LogsunSystems/ESP32_DVK/ESP32 DOCUMENTS/ESP32 DVK SCH/ESP_DVK_NEW_2_NOV/ESP_DVK_NEW_1_NOV/ESP_DVK_NEW/Esp_DVK.brd

## EAGLE design ESP32 DOCUMENTS/ESP32 DVK SCH/ESP_DVK_NEW_2_NOV/ESP_DVK_NEW_1_NOV/ESP_DVK_NEW/Esp_DVK.brd (2023-11-11, last stored version)

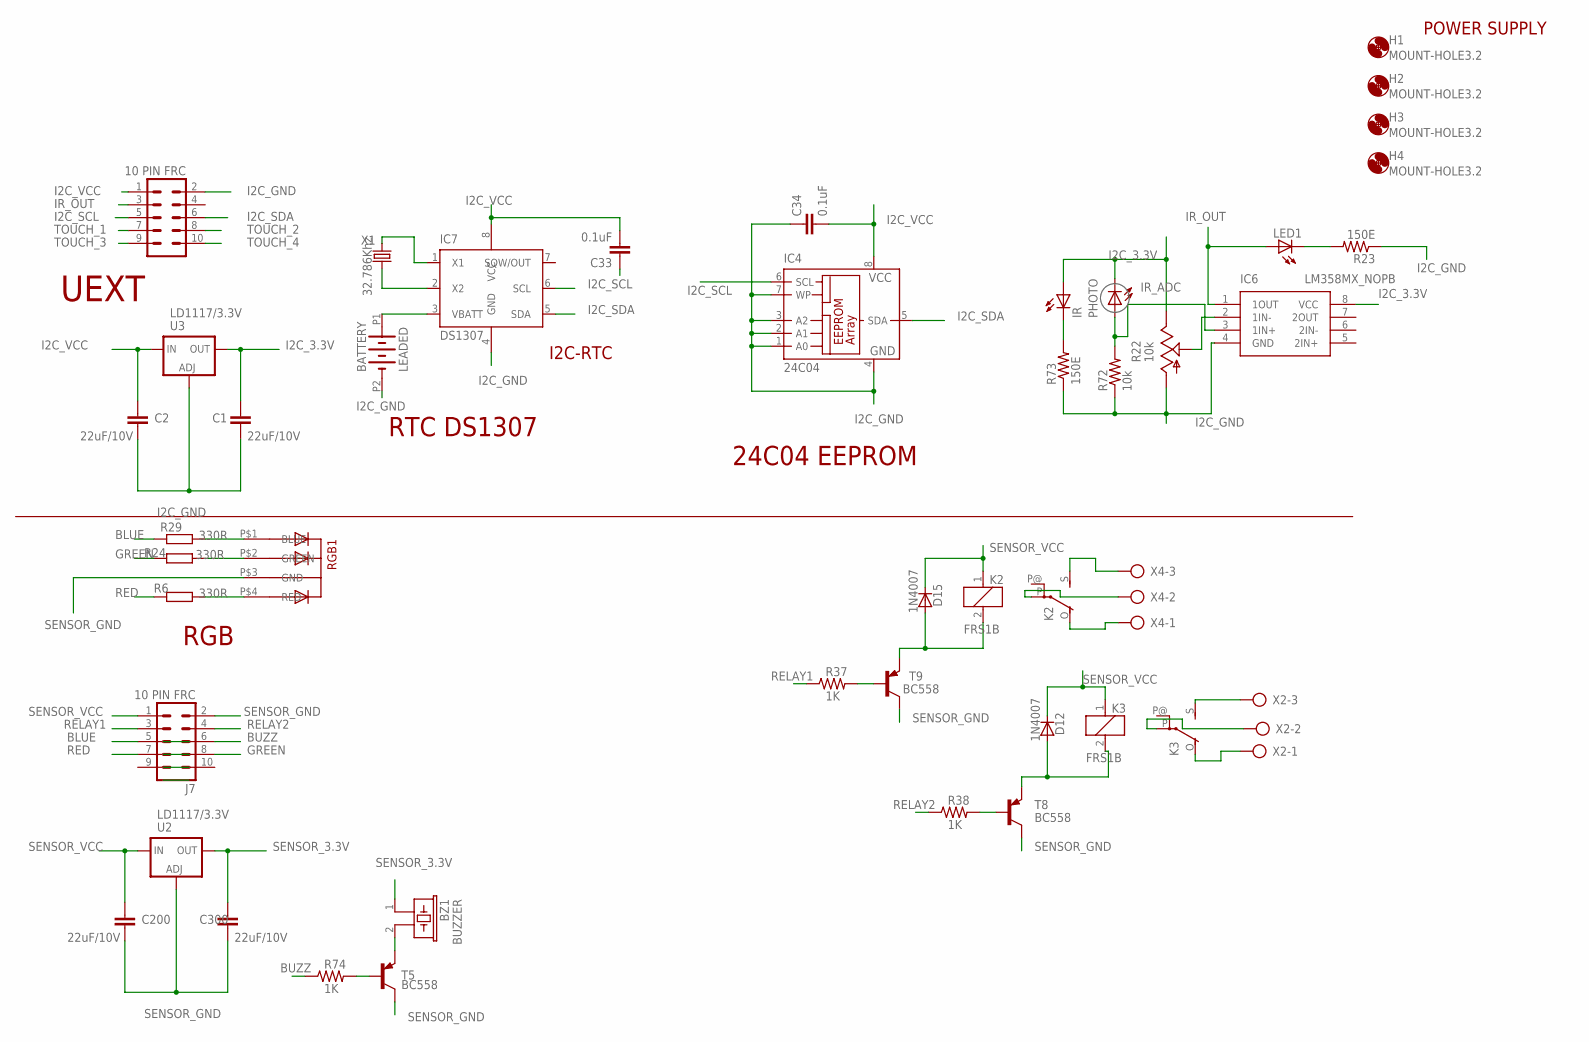
[picture p1: schematic Esp_DVK.sch, sheet 1]

Parts:
BATTERY: LEADED
BZ1: BUZZER; BUZZ
C1, C2, C200, C300: 22uF/10V; C1206
C33, C34: 0.1uF; C1206
D12, D15: 1N4007; MLL34
H1, H2, H3, H4: MOUNT-HOLE3.2; 3,2
IC4: 24C04; SO-08M
IC6: LM358MX_NOPB; SOIC127P600X175-8N
IC7: DS1307; SO08
IR: LED5MM
J3, J7: 10 PIN FRC; ML10
K2, K3: FRS1B
LED1: LEDCHIPLED_1206; CHIPLED_1206
PHOTO: LED5MM
R6, R24, R29: 330R; R1206
R22: 10k; RJ9W
R23, R73: 150E; R1206
R37, R38, R74: 1K; R1206@1
R72: 10k; R1206
RGB1: 5MMRGBLED; LED5MMRGB
T5, T8, T9: BC558; SOT23-EBC
U2, U3: LD1117/3.3V; SOT223
X1: 32.786Khz; TC38H
X2, X4: AK300/3

Connections:
BLUE: J7.5, R29.1
BUZZ: J7.6, R74.1
GREEN: J7.8, R24.1
I2C_3.3V: C1.2, IC6.8 (VCC), IR.A, PHOTO.K (C), R22.E, U3.4 (OUT)
I2C_GND: BATTERY.P2 (-), C1.1, C2.1, C33.1, C34.1, IC4.1 (A0), IC4.2 (A1), IC4.3 (A2), IC4.4 (GND), IC4.7 (WP), IC6.4 (GND), IC7.4 (GND), J3.2, R22.A, R23.1, R72.1, R73.1, U3.1 (ADJ)
I2C_SCL: IC4.6 (SCL), IC7.6 (SCL), J3.5
I2C_SDA: IC4.5 (SDA), IC7.5 (SDA), J3.6
I2C_VCC: C2.2, C33.2, C34.2, IC4.8 (VCC), IC7.8 (VCC), J3.1, U3.3 (IN)
IR_ADC: IC6.3 (1IN+), PHOTO.A, R72.2
IR_OUT: IC6.1 (1OUT), J3.3, LED1.A
unnamed: R24.2, RGB1.P$2 (GREEN)
unnamed: IC6.2 (1IN-), R22.S
unnamed: K3.S, X2.3
unnamed: K2.S, X4.3
unnamed: K2.P, X4.2
unnamed: R29.2, RGB1.P$1 (BLUE)
unnamed: K2.O, X4.1
unnamed: R38.2, T8.B
unnamed: IR.K (C), R73.2
unnamed: R6.2, RGB1.P$4 (RED)
unnamed: LED1.C, R23.2
unnamed: D12.A, K3.2, T8.E
unnamed: K3.P, X2.2
unnamed: K3.O, X2.1
unnamed: IC7.2 (X2), X1.1
unnamed: BATTERY.P1 (+), IC7.3 (VBATT)
unnamed: IC7.1 (X1), X1.2
unnamed: R74.2, T5.B
unnamed: BZ1.2, T5.E
unnamed: R37.2, T9.B
unnamed: D15.A, K2.2, T9.E
RED: J7.7, R6.1
RELAY1: J7.3, R37.1
RELAY2: J7.4, R38.1
SENSOR_3.3V: BZ1.1, C300.2, U2.4 (OUT)
SENSOR_GND: C200.1, C300.1, J7.2, RGB1.P$3 (GND), T5.C, T8.C, T9.C, U2.1 (ADJ)
SENSOR_VCC: C200.2, D12.C, D15.C, J7.1, K2.1, K3.1, U2.3 (IN)
SQW/OUT: IC7.7 (SQW/OUT)
TOUCH_1: J3.7
TOUCH_2: J3.8
TOUCH_3: J3.9
TOUCH_4: J3.10

Notes on the sheet:
POWER SUPPLY
I2C-RTC
RTC DS1307
24C04 EEPROM
UEXT
RGB

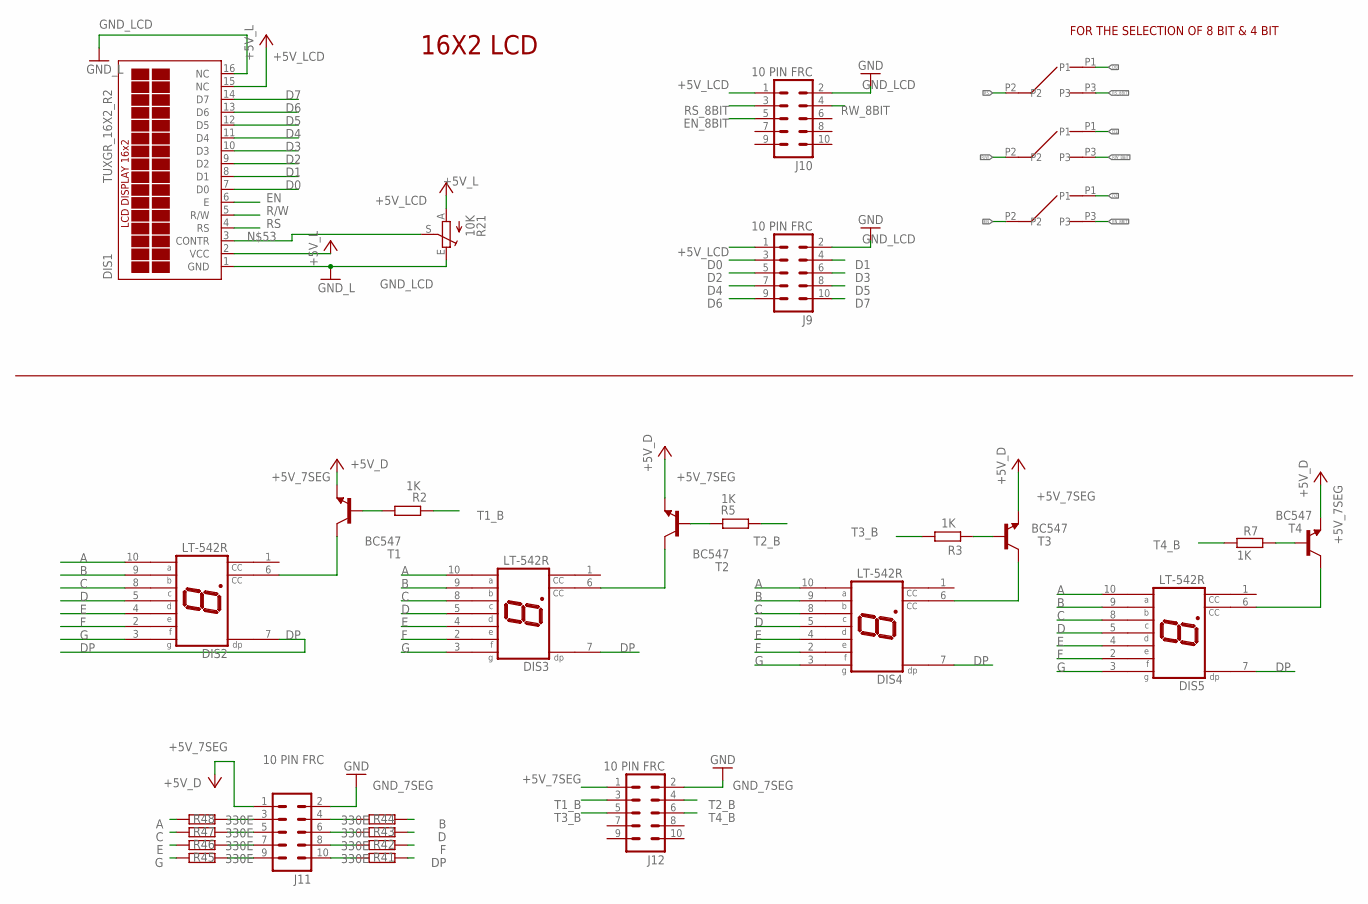
[picture p2: schematic Esp_DVK.sch, sheet 2]

Parts:
DIS1: TUXGR_16X2_R2
DIS2, DIS3, DIS4, DIS5: LT-542R; HDSP-A
EN: SMALLSLIDESW; SLIDESW
J9, J10, J11, J12: 10 PIN FRC; ML10
R2, R3, R5, R7: 1K; M1206
R21: 10K; RJ9W
R41, R42, R43, R44, R45, R46, R47, R48: 330E; R1206
R/W: SMALLSLIDESW; SLIDESW
RS: SMALLSLIDESW; SLIDESW
T1, T2, T3, T4: BC547; TO92

Connections:
+5V_7SEG: J11.1, J12.1, T1.1 (E), T2.1 (E), T3.1 (E), T4.1 (E)
+5V_LCD: DIS1.2 (VCC), DIS1.15 (NC), J9.1, J10.1, R21.A
A: DIS2.10 (A), DIS3.10 (A), DIS4.10 (A), DIS5.10 (A), R48.1
B: DIS2.9 (B), DIS3.9 (B), DIS4.9 (B), DIS5.9 (B), R44.2
C: DIS2.8 (C), DIS3.8 (C), DIS4.8 (C), DIS5.8 (C), R47.1
D: DIS2.5 (D), DIS3.5 (D), DIS4.5 (D), DIS5.5 (D), R43.2
D0: DIS1.7 (D0), J9.3, RS.P1
D1: DIS1.8 (D1), J9.4, R/W.P1
D2: DIS1.9 (D2), EN.P1, J9.5
D3: DIS1.10 (D3), J9.6
D4: DIS1.11 (D4), J9.7
D5: DIS1.12 (D5), J9.8
D6: DIS1.13 (D6), J9.9
D7: DIS1.14 (D7), J9.10
DP: DIS2.7 (DP), DIS3.7 (DP), DIS4.7 (DP), DIS5.7 (DP), R41.2
E: DIS2.4 (E), DIS3.4 (E), DIS4.4 (E), DIS5.4 (E), R46.1
EN: DIS1.6 (E), EN.P2
EN_8BIT: EN.P3, J10.5
F: DIS2.2 (F), DIS3.2 (F), DIS4.2 (F), DIS5.2 (F), R42.2
G: DIS2.3 (G), DIS3.3 (G), DIS4.3 (G), DIS5.3 (G), R45.1
GND_7SEG: J11.2, J12.2
GND_LCD: DIS1.1 (GND), DIS1.16 (NC), J9.2, J10.2, R21.E
unnamed: R3.1, T3.2 (B)
unnamed: R2.1, T1.2 (B)
unnamed: DIS2.6 (CC), T1.3 (C)
unnamed: DIS4.6 (CC), T3.3 (C)
unnamed: R5.1, T2.2 (B)
unnamed: DIS3.6 (CC), T2.3 (C)
unnamed: R7.1, T4.2 (B)
unnamed: DIS5.6 (CC), T4.3 (C)
unnamed: J11.4, R44.1
unnamed: J11.6, R43.1
unnamed: J11.8, R42.1
unnamed: J11.10, R41.1
unnamed: J11.3, R48.2
unnamed: J11.5, R47.2
unnamed: DIS1.3 (CONTR), R21.S
unnamed: J11.7, R46.2
unnamed: J11.9, R45.2
R/W: DIS1.5 (R/W), R/W.P2
RS: DIS1.4 (RS), RS.P2
RS_8BIT: J10.3, RS.P3
RW_8BIT: J10.4, R/W.P3
T1_B: J12.3, R2.2
T2_B: J12.4, R5.2
T3_B: J12.5, R3.2
T4_B: J12.6, R7.2

Notes on the sheet:
16X2 LCD
FOR THE SELECTION OF 8 BIT & 4 BIT

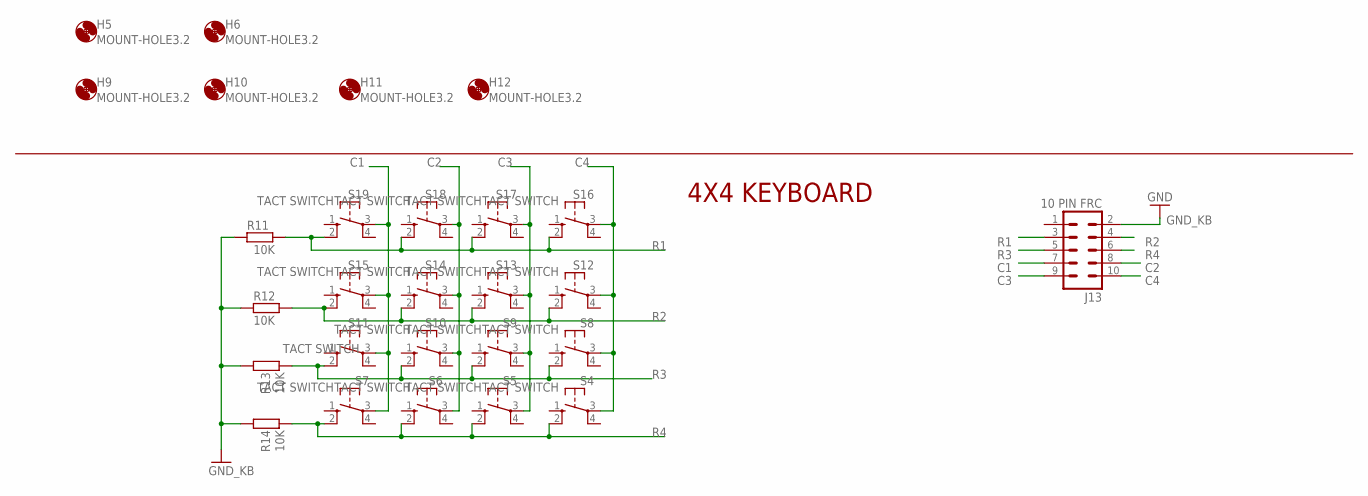
[picture p3: schematic Esp_DVK.sch, sheet 3]

Parts:
H5, H6, H9, H10, H11, H12: MOUNT-HOLE3.2; 3,2
J13: 10 PIN FRC; ML10
R11, R12, R13, R14: 10K; R1206
S4, S5, S6., S7, S8, S9, S10, S11, S12, S13, S14, S15, S16, S17, S18, S19: TACT SWITCH; B3F-10XX

Connections:
C1: J13.7, S7.3, S11.3, S15.3, S19.3
C2: J13.8, S6..3, S10.3, S14.3, S18.3
C3: J13.9, S5.3, S9.3, S13.3, S17.3
C4: J13.10, S4.3, S8.3, S12.3, S16.3
GND_KB: J13.2, R11.2, R12.2, R13.2, R14.2
R1: J13.3, R11.1, S16.2 (S1), S17.2 (S1), S18.2 (S1), S19.2 (S1)
R2: J13.4, R12.1, S12.2 (S1), S13.2 (S1), S14.2 (S1), S15.2 (S1)
R3: J13.5, R13.1, S8.2 (S1), S9.2 (S1), S10.2 (S1), S11.2 (S1)
R4: J13.6, R14.1, S4.2 (S1), S5.2 (S1), S6..2 (S1), S7.2 (S1)

Notes on the sheet:
4X4 KEYBOARD

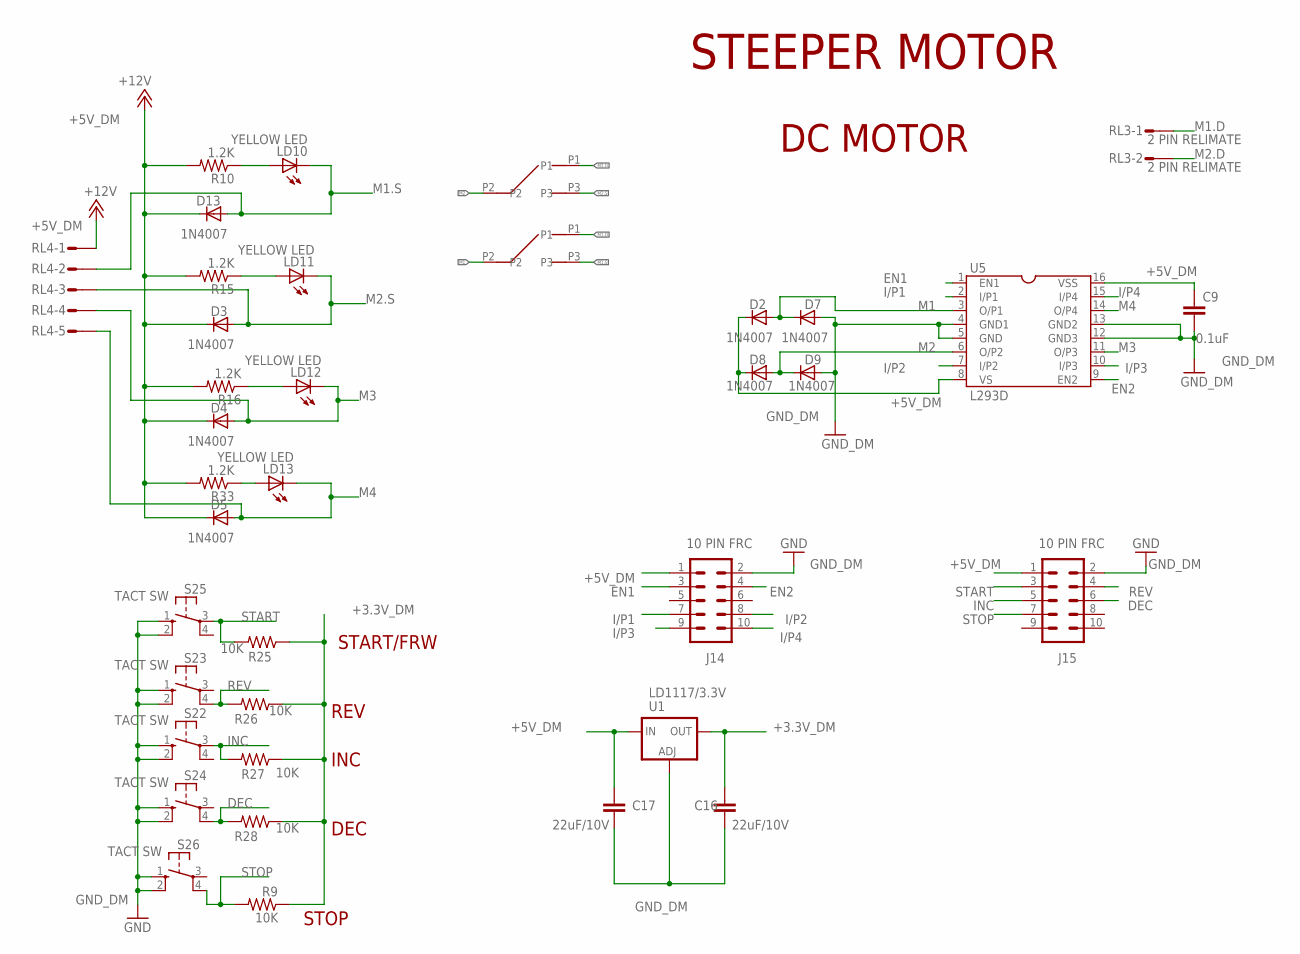
[picture p4: schematic Esp_DVK.sch, sheet 4]

Parts:
C9: 0.1uF; C1206
C16, C17: 22uF/10V; C1206
D2, D3, D4, D5, D7, D8, D9, D13: 1N4007; MLL34
J14, J15: 10 PIN FRC; ML10
LD10, LD11, LD12, LD13: YELLOW LED; CHIPLED_1206
R9, R25, R26, R27, R28: 10K; R1206@1
R10, R15, R16, R33: 1.2K; R1206@1
RL3: 2 PIN RELIMATE; S02P
RL4: S05P
S22, S23, S24, S25, S26: TACT SW; B3F-10XX
S_14, S_15: SMALLSLIDESW; SLIDESW
U1: LD1117/3.3V; SOT223
U5: L293D; SOCKET-16

Connections:
+3.3V_DM: C16.2, R9.1, R25.1, R26.1, R27.1, R28.1, U1.4 (OUT)
+5V_DM: C9.2, C17.2, D2.C, D3.C, D4.C, D5.C, D8.C, D13.C, J14.1, J15.1, R10.2, R15.2, R16.2, R33.2, RL4.1, U1.3 (IN), U5.8 (VS), U5.16 (VSS)
DEC: J15.6, R28.2, S24.4 (P1)
EN1: J14.3, U5.1 (EN1)
EN2: J14.4, U5.9 (EN2)
GND_DM: C9.1, C16.1, C17.1, D7.A, D9.A, J14.2, J15.2, S22.1 (S), S22.2 (S1), S23.1 (S), S23.2 (S1), S24.1 (S), S24.2 (S1), S25.1 (S), S25.2 (S1), S26.1 (S), S26.2 (S1), U1.1 (ADJ), U5.4 (GND1), U5.5 (GND), U5.12 (GND3), U5.13 (GND2)
I/P1: J14.7, U5.2 (I/P1)
I/P2: J14.8, U5.7 (I/P2)
I/P3: J14.9, U5.10 (I/P3)
I/P4: J14.10, U5.15 (I/P4)
INC: J15.5, R27.2, S22.3
M1: D2.A, D7.C, S_15.P2, U5.3 (O/P1)
M1.D: RL3.1, S_15.P1
M1.S: D13.A, LD10.C, RL4.2, S_15.P3
M2: D8.A, D9.C, S_14.P2, U5.6 (O/P2)
M2.D: RL3.2, S_14.P1
M2.S: D3.A, LD11.C, RL4.3, S_14.P3
M3: D4.A, LD12.C, RL4.4, U5.11 (O/P3)
M4: D5.A, LD13.C, RL4.5, U5.14 (O/P4)
unnamed: LD10.A, R10.1
unnamed: LD11.A, R15.1
unnamed: LD12.A, R16.1
unnamed: LD13.A, R33.1
REV: J15.4, R26.2, S23.4 (P1)
START: J15.3, R25.2, S25.3
STOP: J15.7, R9.2, S26.4 (P1)

Notes on the sheet:
DC MOTOR
START/FRW
REV
INC
DEC
STOP
STEEPER MOTOR

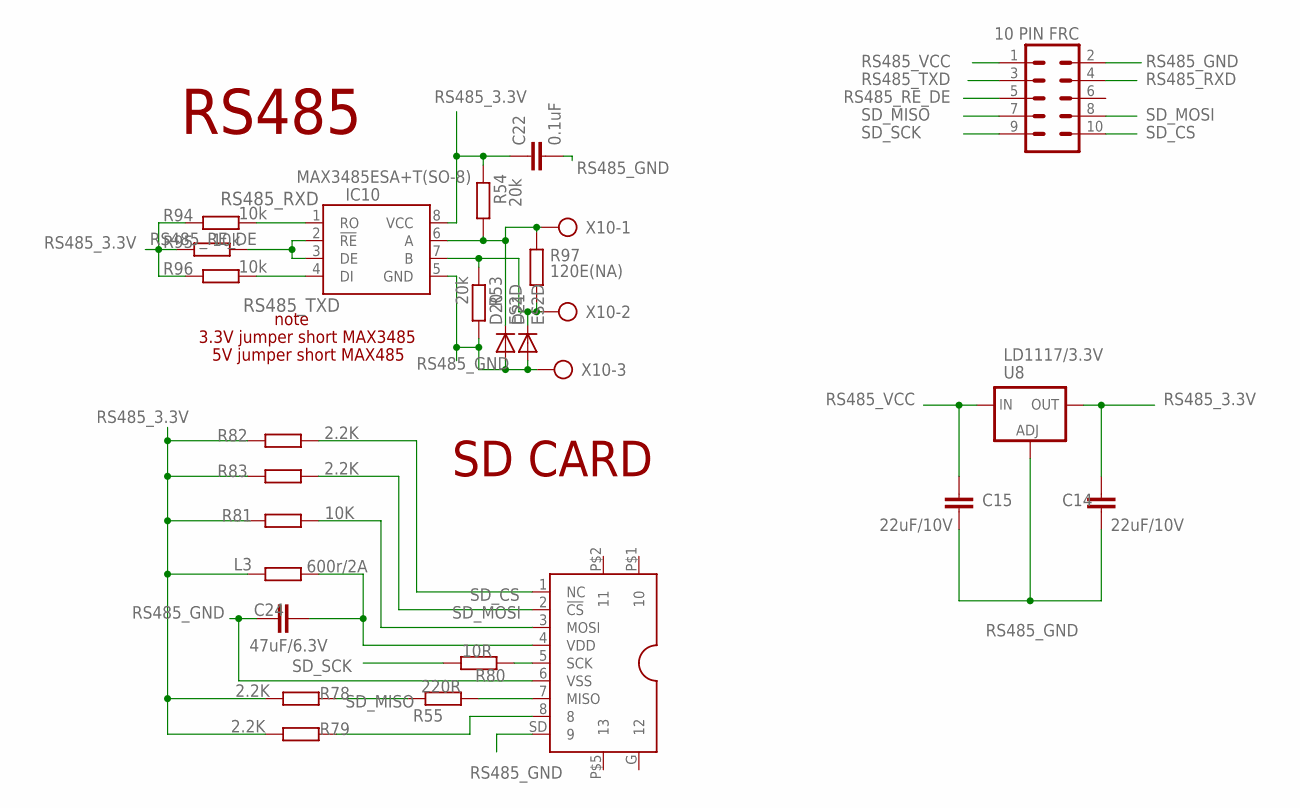
[picture p5: schematic Esp_DVK.sch, sheet 5]

Parts:
C14, C15: 22uF/10V; C1206
C22: 0.1uF; C0805
C24: 47uF/6.3V; C1206
D20, D21: ES2D; SMB
IC10: MAX3485ESA+T(SO-8); SOIC8
J5: 10 PIN FRC; ML10
L3: 600r/2A; R1206
R53, R54: 20k; R1206
R55: 220R; R1206
R78, R79, R82, R83: 2.2K; R1206
R80: 10R; R1206
R81: 10K; R1206
R94, R95, R96: 10k; R1206
R97: 120E(NA); R1206
U8: LD1117/3.3V; SOT223
X5: SDCARD-TF07; SDCARD
X10: AK300/3

Connections:
unnamed: D21.C, IC10.7 (B), R53.1, R97.2, X10.2
unnamed: D20.C, IC10.6 (A), R54.2, R97.1, X10.1
unnamed: R82.1, X5.1 (NC)
unnamed: C24.2, L3.1, X5.4 (VDD)
unnamed: R80.1, X5.5 (SCK)
unnamed: R55.1, X5.7 (MISO)
unnamed: R79.1, X5.8
RS485_3.3V: C14.2, C22.1, IC10.8 (VCC), L3.2, R54.1, R78.2, R79.2, R81.2, R82.2, R83.2, R94.1, R95.1, R96.1, U8.4 (OUT)
RS485_GND: C14.1, C15.1, C22.2, C24.1, D20.A, D21.A, IC10.5 (GND), J5.2, R53.2, U8.1 (ADJ), X5.6 (VSS), X5.SD (9), X10.3
RS485_RE_DE: IC10.2 (!RE), IC10.3 (DE), J5.5, R95.2
RS485_RXD: IC10.1 (RO), J5.4, R94.2
RS485_TXD: IC10.4 (DI), J5.3, R96.2
RS485_VCC: C15.2, J5.1, U8.3 (IN)
SD_CS: J5.10, R83.1, X5.2 (!CS)
SD_MISO: J5.7, R55.2, R78.1
SD_MOSI: J5.8, R81.1, X5.3 (MOSI)
SD_SCK: J5.9, R80.2

Notes on the sheet:
RS485
SD CARD
note
3.3V jumper short MAX3485
5V jumper short MAX485

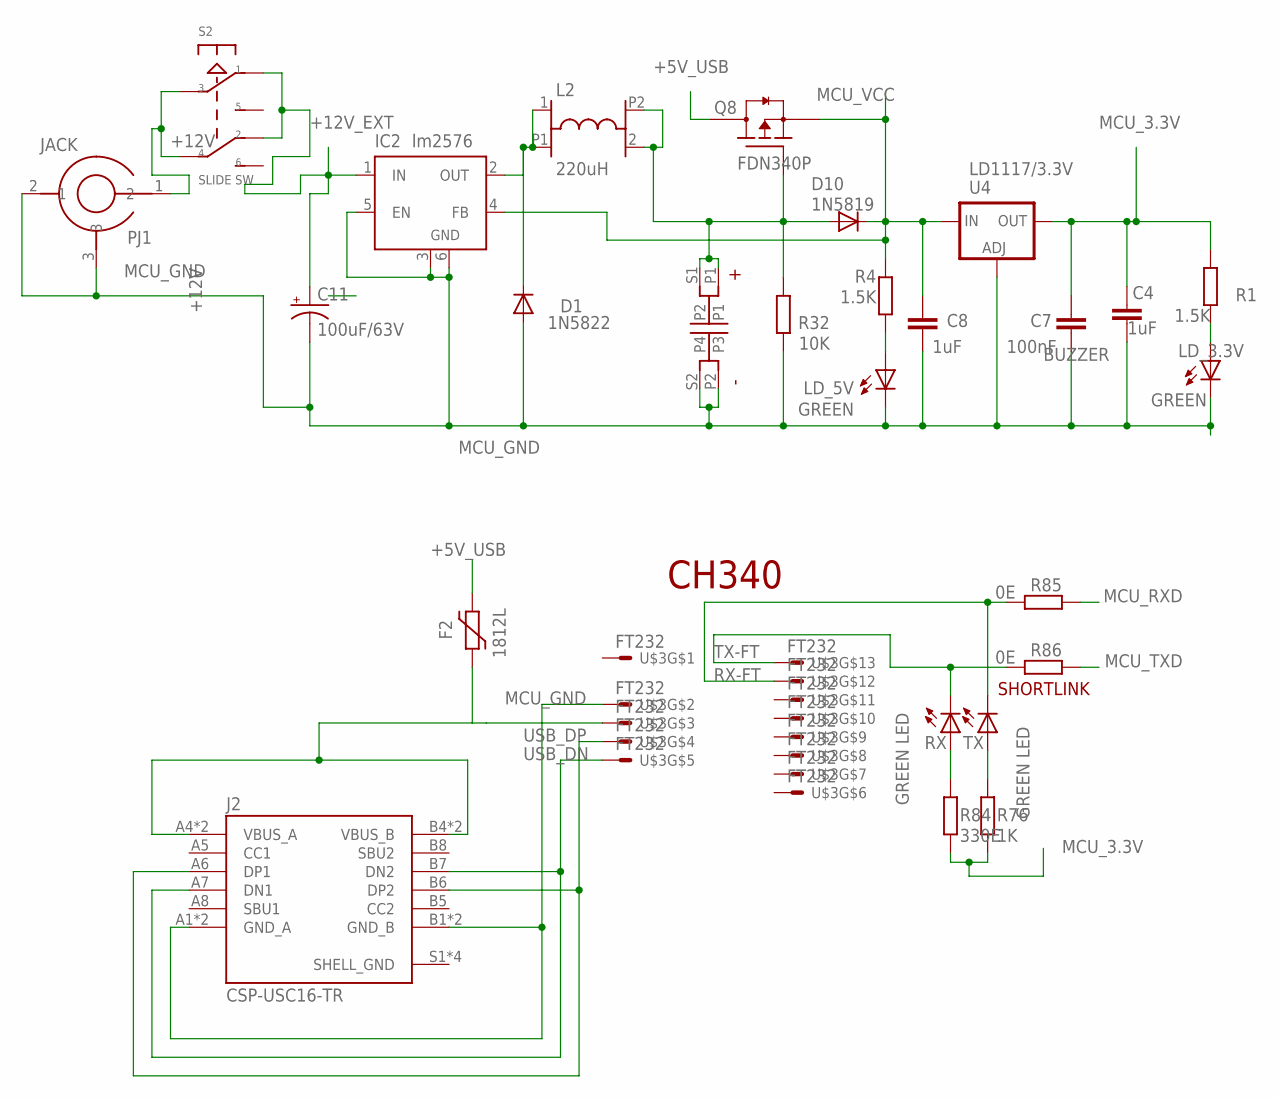
[picture p6: schematic Esp_DVK.sch, sheet 6]

Parts:
C4, C8: 1uF; C1206
C7: 100nF; C1206
C11: 100uF/63V; E3,5-10
C21: 1000uF/63V; 140CLH-1010
D1: 1N5822; DO201-15
D10: 1N5819; DO41-10
F2: 1812L
IC2: lm2576; TO263-5
J2: CSP-USC16-TR; VALCON_CSP-USC16-TR
L2: 220uH; MS42
LD_3.3V, LD_5V: GREEN; LED3MM
PJ1: JACK
Q8: FDN340P; SOT95P280X135-3N
R1, R4: 1.5K; R1206
R32: 10K; R1206
R76: 1K; R1206
R84: 330E; R1206
R85, R86: 0E; R1206
RX: GREEN LED; CHIPLED_1206
S2: SLIDE SW; SLIDE
TX: GREEN LED; CHIPLED_1206
U4: LD1117/3.3V; SOT223
U$3: FT232

Connections:
+5V_USB: F2.P$2 (2), Q8.3 (D)
+12V: PJ1.1 (2), S2.3, S2.4
+12V_EXT: C11.+, IC2.1 (IN), S2.1, S2.2
MCU_3.3V: C4.2, C7.2, R1.2, R76.1, R84.1, U4.4 (OUT); also elsewhere on the board
MCU_GND: C4.1, C7.1, C8.1, C11.-, C21.P2 (P3), C21.S2 (P4), D1.A, IC2.3 (GND), IC2.5 (EN), IC2.6 (GND), J2.A1 (GND_A), J2.A12 (GND_A), J2.B1 (GND_B), J2.B12 (GND_B), LD_3.3V.K (C), LD_5V.K (C), PJ1.2 (1), PJ1.3, R32.1, U4.1 (ADJ), U$3.2; also elsewhere on the board
MCU_RXD: R85.2; also elsewhere on the board
MCU_TXD: R86.2; also elsewhere on the board
MCU_VCC: C8.2, D10.C, IC2.4 (FB), Q8.2 (S), R4.2, U4.3 (IN); also elsewhere on the board
unnamed: D1.C, IC2.2 (OUT), L2.1, L2.P1 (2)
unnamed: F2.P$1 (1), J2.A4 (VBUS_A), J2.A9 (VBUS_A), J2.B4 (VBUS_B), J2.B9 (VBUS_B), U$3.3
unnamed: LD_5V.A, R4.1
unnamed: C21.P1, C21.S1 (P2), D10.A, L2.2 (3), L2.P2 (4), Q8.1 (G), R32.2
unnamed: LD_3.3V.A, R1.1
unnamed: R76.2, TX.A
unnamed: R84.2, RX.A
RX-FT: R85.1, TX.C, U$3.12
SHELL_GND: J2.S1 (SHELL_GND), J2.S2 (SHELL_GND), J2.S3 (SHELL_GND), J2.S4 (SHELL_GND)
TX-FT: R86.1, RX.C, U$3.13
USB_DN: J2.A7 (DN1), J2.B7 (DN2), U$3.5
USB_DP: J2.A6 (DP1), J2.B6 (DP2), U$3.4

Notes on the sheet:
BUZZER
CH340
SHORTLINK

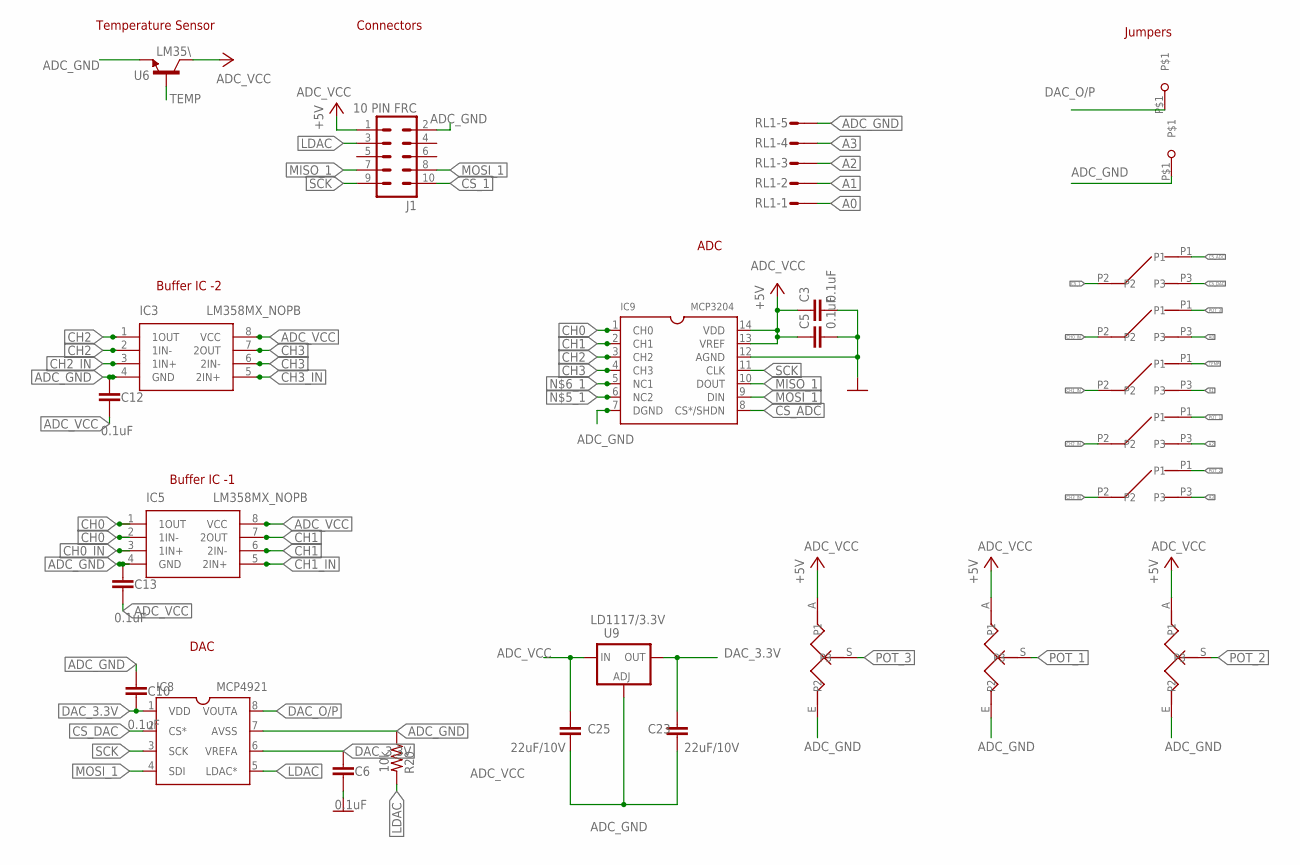
[picture p7: schematic Esp_DVK.sch, sheet 7]

Parts:
C3, C5, C6, C10, C12, C13: 0.1uF; C1206
C23, C25: 22uF/10V; C1206
DACO/P: TEST_PAD; 3.2MM
GND: TEST_PAD; 3.2MM
IC3, IC5: LM358MX_NOPB; SOIC127P600X175-8N
IC8: MCP4921; SOIC-8N
IC9: MCP3204; SOIC-14N
J1: 10 PIN FRC; ML10
POT1, POT2, POT3: 10K; CA6V
R20: 10k; R1206@1
RL1: S05P
S_9, S_10, S_11, S_12, S_13: SMALLSLIDESW; SLIDESW
U6: LM35\; TO92
U9: LD1117/3.3V; SOT223

Connections:
A0: RL1.1, S_10.P3
A1: RL1.2, S_11.P3
A2: RL1.3, S_12.P3
A3: RL1.4, S_13.P3
ADC_GND: C10.1, C12.1, C13.1, C23.1, C25.1, GND.P$1, IC3.4 (GND), IC5.4 (GND), IC8.7 (AVSS), IC9.7 (DGND), J1.2, POT1.E (P2), POT2.E (P2), POT3.E (P2), R20.1, RL1.5, U6.1 (E), U9.1 (ADJ)
ADC_VCC: C3.1, C5.1, C12.2, C13.2, C25.2, IC3.8 (VCC), IC5.8 (VCC), IC9.13 (VREF), IC9.14 (VDD), J1.1, POT1.A (P1), POT2.A (P1), POT3.A (P1), U6.3 (C), U9.3 (IN)
CH0: IC5.1 (1OUT), IC5.2 (1IN-), IC9.1 (CH0)
CH0_IN: IC5.3 (1IN+), S_10.P2
CH1: IC5.6 (2IN-), IC5.7 (2OUT), IC9.2 (CH1)
CH1_IN: IC5.5 (2IN+), S_11.P2
CH2: IC3.1 (1OUT), IC3.2 (1IN-), IC9.3 (CH2)
CH2_IN: IC3.3 (1IN+), S_12.P2
CH3: IC3.6 (2IN-), IC3.7 (2OUT), IC9.4 (CH3)
CH3_IN: IC3.5 (2IN+), S_13.P2
CS_1: J1.10, S_9.P2
CS_ADC: IC9.8 (CS*/SHDN), S_9.P1
CS_DAC: IC8.2 (CS*), S_9.P3
DAC_3.3V: C6.1, C10.2, C23.2, IC8.1 (VDD), IC8.6 (VREFA), U9.4 (OUT)
DAC_O/P: DACO/P.P$1, IC8.8 (VOUTA)
GND_ADC: C3.2, C5.2, C6.2, IC9.12 (AGND)
LDAC: IC8.5 (LDAC*), J1.3, R20.2
MISO_1: IC9.10 (DOUT), J1.7
MOSI_1: IC8.4 (SDI), IC9.9 (DIN), J1.8
POT_1: POT3.S (P3), S_12.P1
POT_2: POT2.S (P3), S_13.P1
POT_3: POT1.S (P3), S_10.P1
SCK: IC8.3 (SCK), IC9.11 (CLK), J1.9
TEMP: S_11.P1, U6.2 (B)

Notes on the sheet:
Temperature Sensor
Connectors
ADC
DAC
Jumpers
Buffer IC -1
Buffer IC -2

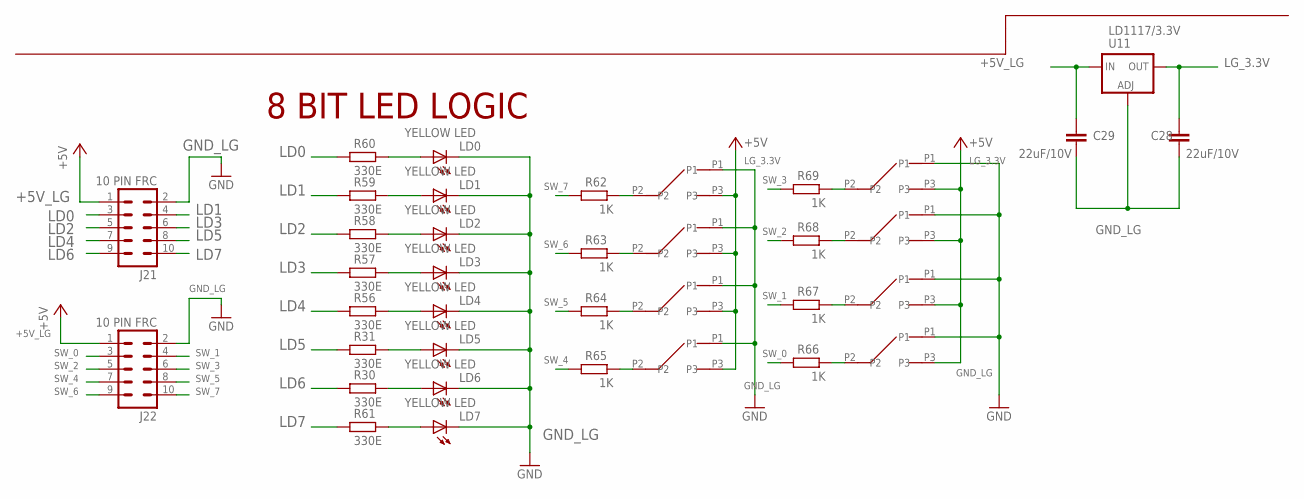
[picture p8: schematic Esp_DVK.sch, sheet 8]

Parts:
C28, C29: 22uF/10V; C1206
J21, J22: 10 PIN FRC; ML10
L4, L5, L6, L7, L8, L9, L10, L11: YELLOW LED; CHIPLED_1206
R30, R31, R56, R57, R58, R59, R60, R61: 330E; R1206
R62, R63, R64, R65, R66, R67, R68, R69: 1K; R1206
S_1, S_2, S_3, S_4, S_5, S_6, S_7, S_8: SMALLSLIDESW; SLIDESW
U11: LD1117/3.3V; SOT223

Connections:
+5V_LG: C29.2, J21.1, J22.1, U11.3 (IN)
GND_LG: C28.1, C29.1, J21.2, J22.2, L4.C, L5.C, L6.C, L7.C, L8.C, L9.C, L10.C, L11.C, S_1.P1, S_2.P1, S_3.P1, S_4.P1, S_5.P1, S_6.P1, S_7.P1, S_8.P1, U11.1 (ADJ)
LD0: J21.3, R60.1
LD1: J21.4, R59.1
LD2: J21.5, R58.1
LD3: J21.6, R57.1
LD4: J21.7, R56.1
LD5: J21.8, R31.1
LD6: J21.9, R30.1
LD7: J21.10, R61.1
LG_3.3V: C28.2, S_1.P3, S_2.P3, S_3.P3, S_4.P3, S_5.P3, S_6.P3, S_7.P3, S_8.P3, U11.4 (OUT)
unnamed: L4.A, R60.2
unnamed: L5.A, R59.2
unnamed: R62.2, S_8.P2
unnamed: L6.A, R58.2
unnamed: L7.A, R57.2
unnamed: L8.A, R56.2
unnamed: L9.A, R31.2
unnamed: L10.A, R30.2
unnamed: L11.A, R61.2
unnamed: R63.2, S_7.P2
unnamed: R64.2, S_6.P2
unnamed: R65.2, S_5.P2
unnamed: R69.2, S_4.P2
unnamed: R68.2, S_3.P2
unnamed: R67.2, S_2.P2
unnamed: R66.2, S_1.P2
SW_0: J22.3, R66.1
SW_1: J22.4, R67.1
SW_2: J22.5, R68.1
SW_3: J22.6, R69.1
SW_4: J22.7, R65.1
SW_5: J22.8, R64.1
SW_6: J22.9, R63.1
SW_7: J22.10, R62.1

Notes on the sheet:
8 BIT LED LOGIC
