LogsunSystems/ESP32_DVK/ESP32 DOCUMENTS/ESP32 DVK SCH/ESP_DVK_NEW_2_NOV/ESP_DVK_NEW_1_NOV/ESP_DVK_NEW/Esp_DVK.brd

## EAGLE design ESP32 DOCUMENTS/ESP32 DVK SCH/ESP_DVK_NEW_2_NOV/ESP_DVK_NEW_1_NOV/ESP_DVK_NEW/Esp_DVK.brd (continued)

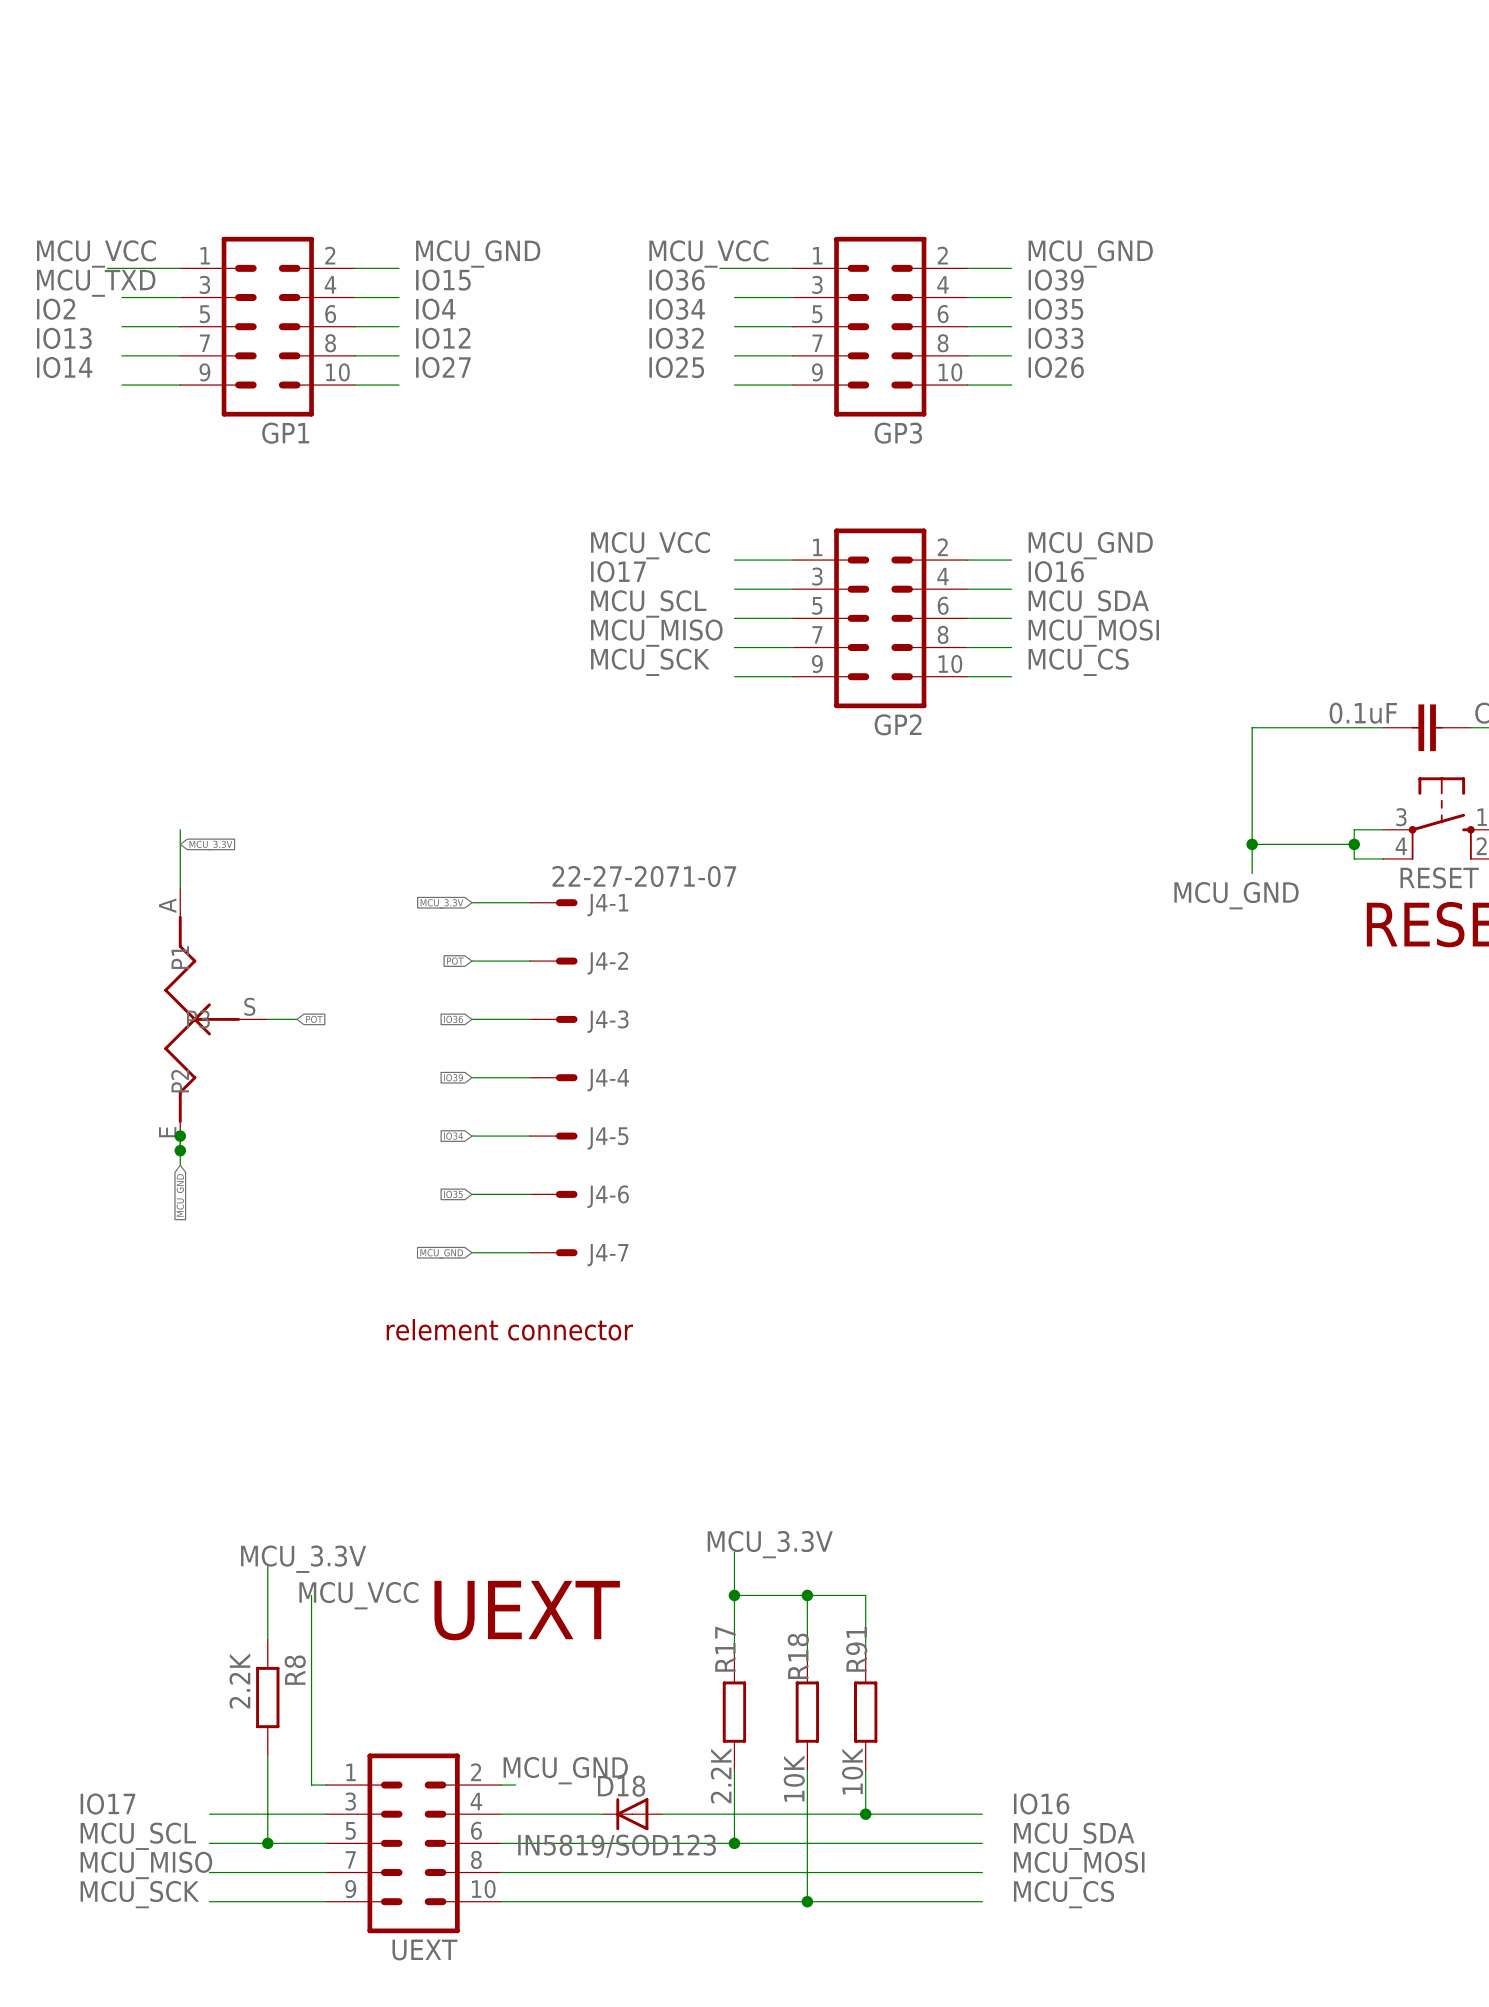
[picture p9: schematic Esp_DVK.sch, sheet 9, part in row 1, column 1]

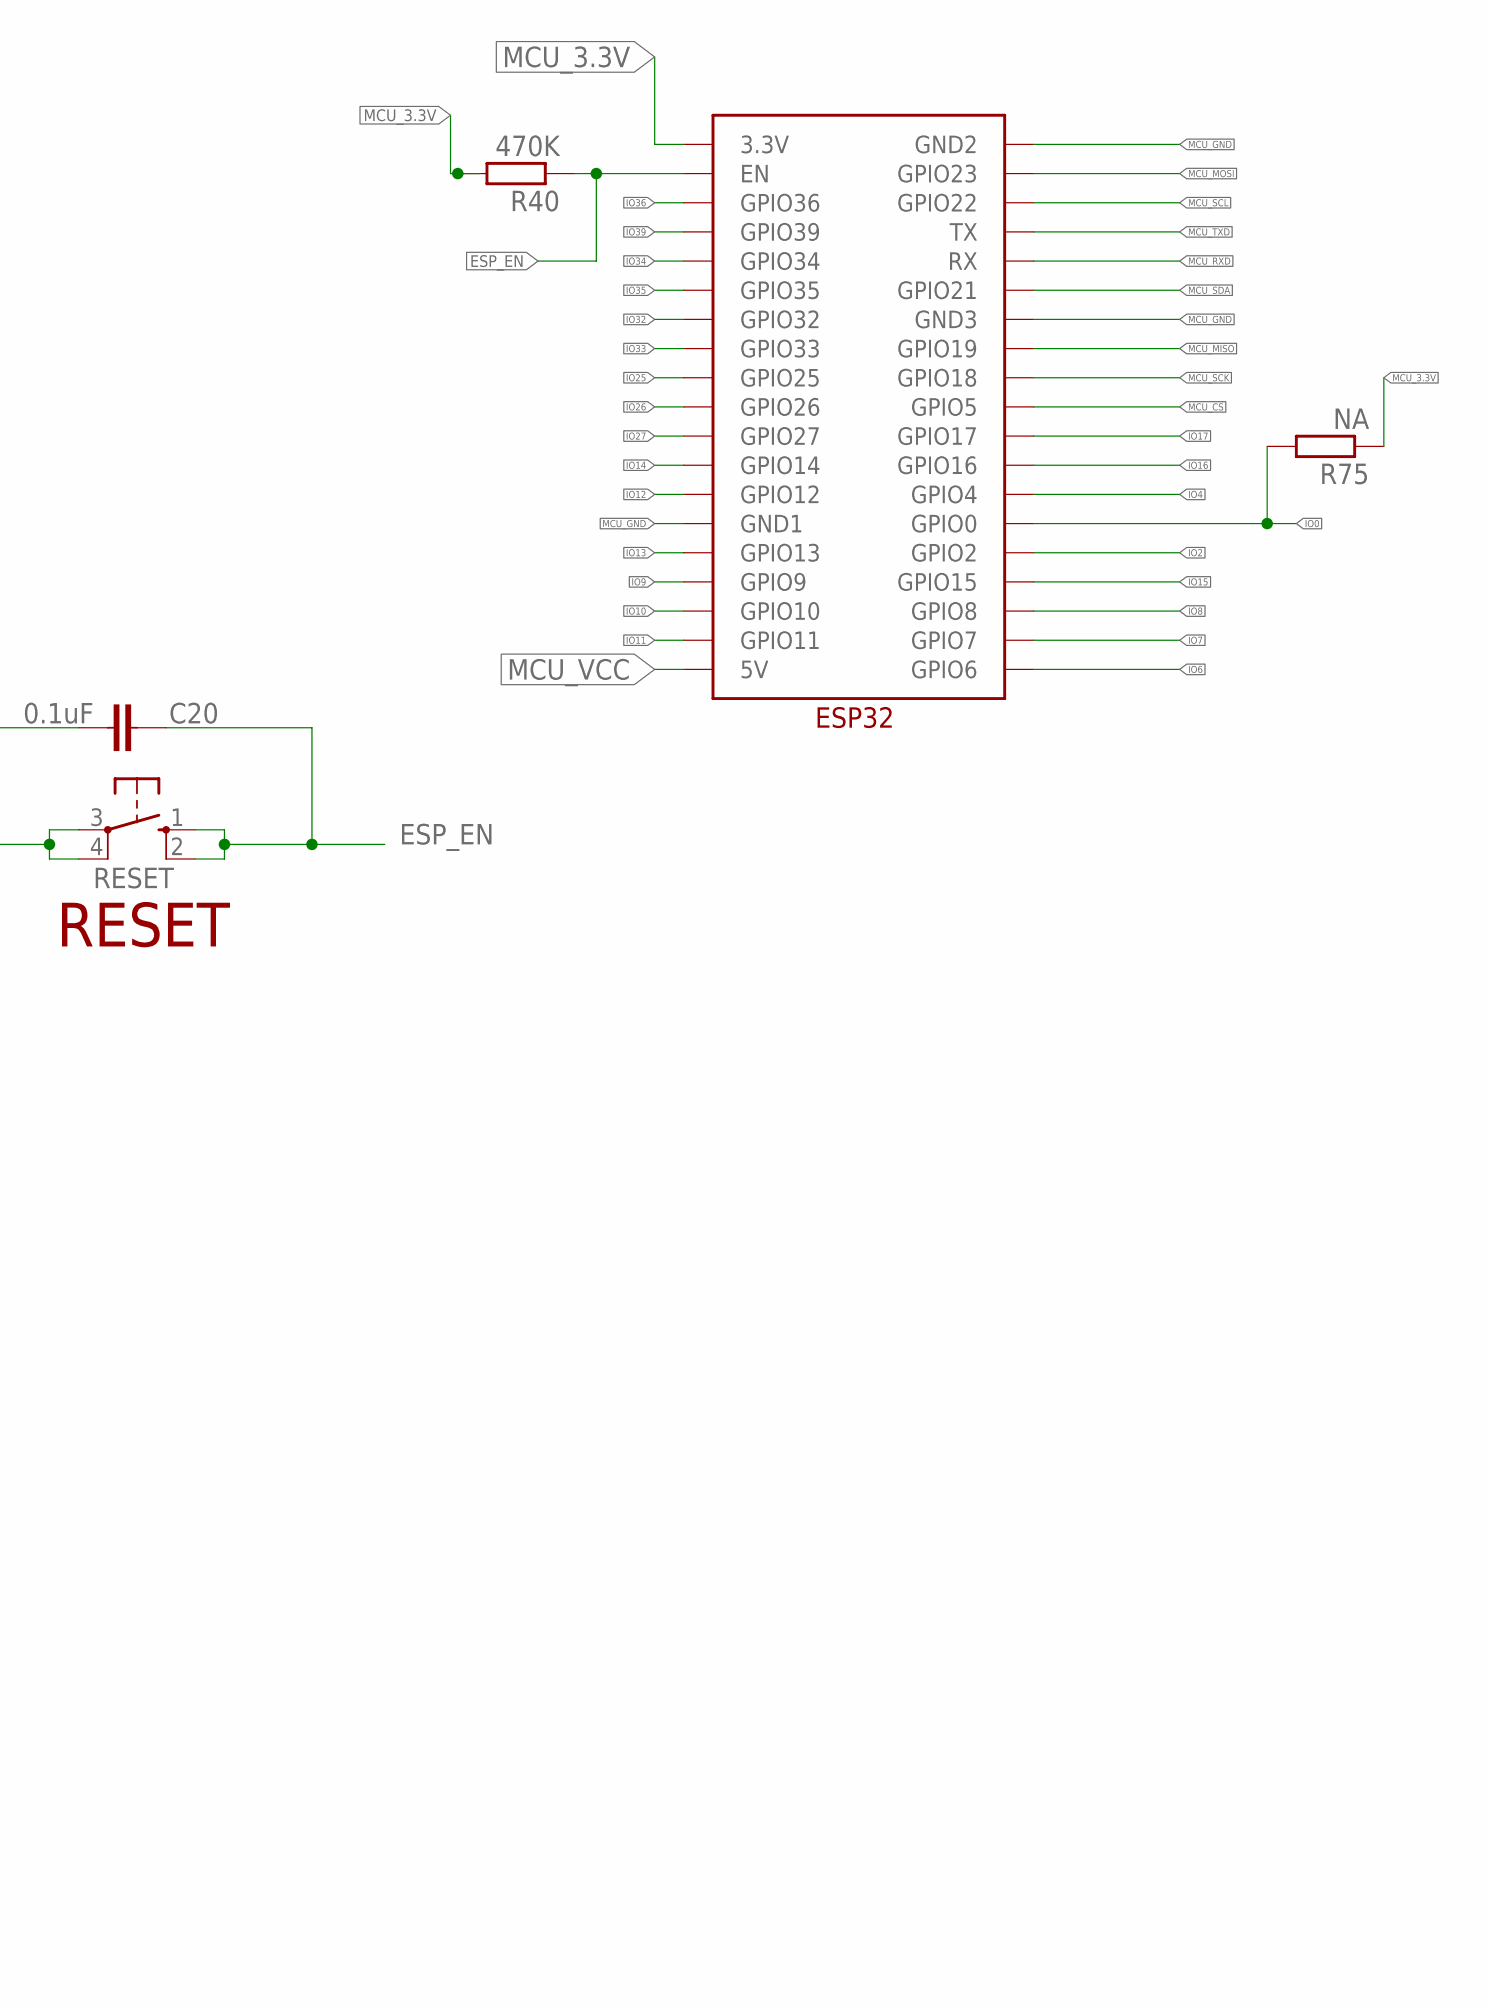
[picture p10: schematic Esp_DVK.sch, sheet 9, part in row 1, column 2]

Parts:
C20: 0.1uF; C1206
D18: IN5819/SOD123; SOD123
GP1, GP2, GP3: ML10
J4: 22-27-2071-07; 6410-07
POT4: 10K; CA6V
R8, R17: 2.2K; R1206
R18, R91: 10K; R1206
R40: 470K; R1206
R75: NA; R1206
RESET: 10-XX; B3F-10XX
U$4: ESP32
UEXT: ML10

Connections:
ESP_EN: C20.1, R40.1, RESET.1 (S), RESET.2 (S1), U$4.EN
IO0: R75.2, U$4.GPIO0
IO2: GP1.5, U$4.GPIO2
IO4: GP1.6, U$4.GPIO4
IO6: U$4.GPIO6
IO7: U$4.GPIO7
IO8: U$4.GPIO8
IO9: U$4.GPIO9
IO10: U$4.GPIO10
IO11: U$4.GPIO11
IO12: GP1.8, U$4.GPIO12
IO13: GP1.7, U$4.GPIO13
IO14: GP1.9, U$4.GPIO14
IO15: GP1.4, U$4.GPIO15
IO16: D18.A, GP2.4, R91.2, U$4.GPIO16
IO17: GP2.3, U$4.GPIO17, UEXT.3
IO25: GP3.9, U$4.GPIO25
IO26: GP3.10, U$4.GPIO26
IO27: GP1.10, U$4.GPIO27
IO32: GP3.7, U$4.GPIO32
IO33: GP3.8, U$4.GPIO33
IO34: GP3.5, J4.5, U$4.GPIO34
IO35: GP3.6, J4.6, U$4.GPIO35
IO36: GP3.3, J4.3, U$4.GPIO36
IO39: GP3.4, J4.4, U$4.GPIO39
MCU_3.3V: J4.1, POT4.A (P1), R8.1, R17.1, R18.1, R40.2, R75.1, R91.1, U$4.3.3V; also elsewhere on the board
MCU_CS: GP2.10, R18.2, U$4.GPIO5, UEXT.10
MCU_GND: C20.2, GP1.2, GP2.2, GP3.2, J4.7, POT4.E (P2), RESET.3, RESET.4 (P1), U$4.GND1, U$4.GND2, U$4.GND3, UEXT.2; also elsewhere on the board
MCU_MISO: GP2.7, U$4.GPIO19, UEXT.7
MCU_MOSI: GP2.8, U$4.GPIO23, UEXT.8
MCU_RXD: U$4.RX; also elsewhere on the board
MCU_SCK: GP2.9, U$4.GPIO18, UEXT.9
MCU_SCL: GP2.5, R8.2, U$4.GPIO22, UEXT.5
MCU_SDA: GP2.6, R17.2, U$4.GPIO21, UEXT.6
MCU_TXD: GP1.3, U$4.TX; also elsewhere on the board
MCU_VCC: GP1.1, GP2.1, GP3.1, U$4.5V, UEXT.1; also elsewhere on the board
unnamed: D18.C, UEXT.4
POT: J4.2, POT4.S (P3)

Notes on the sheet:
RESET
UEXT
relement connector

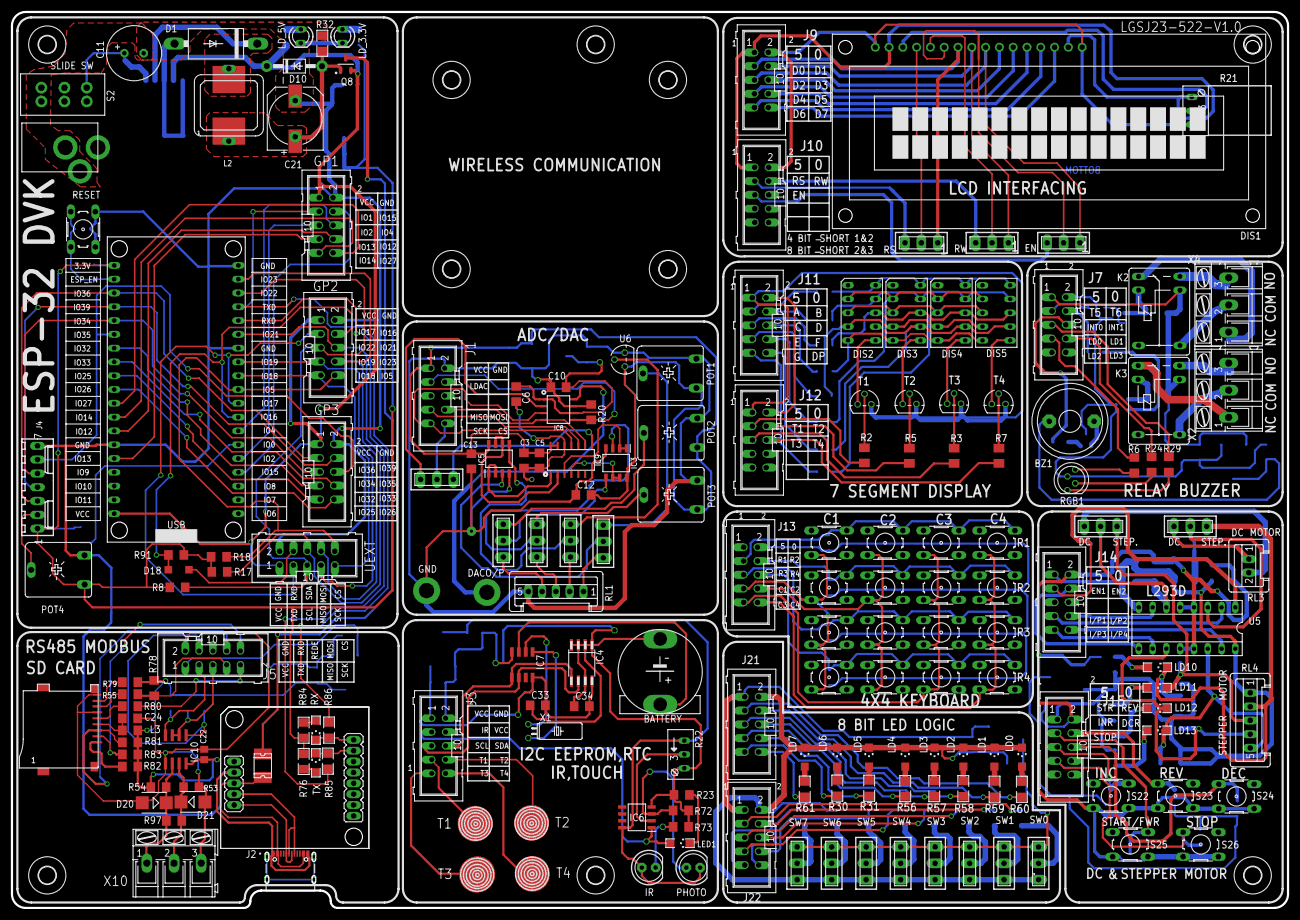
[picture p11: board Esp_DVK.brd from above]

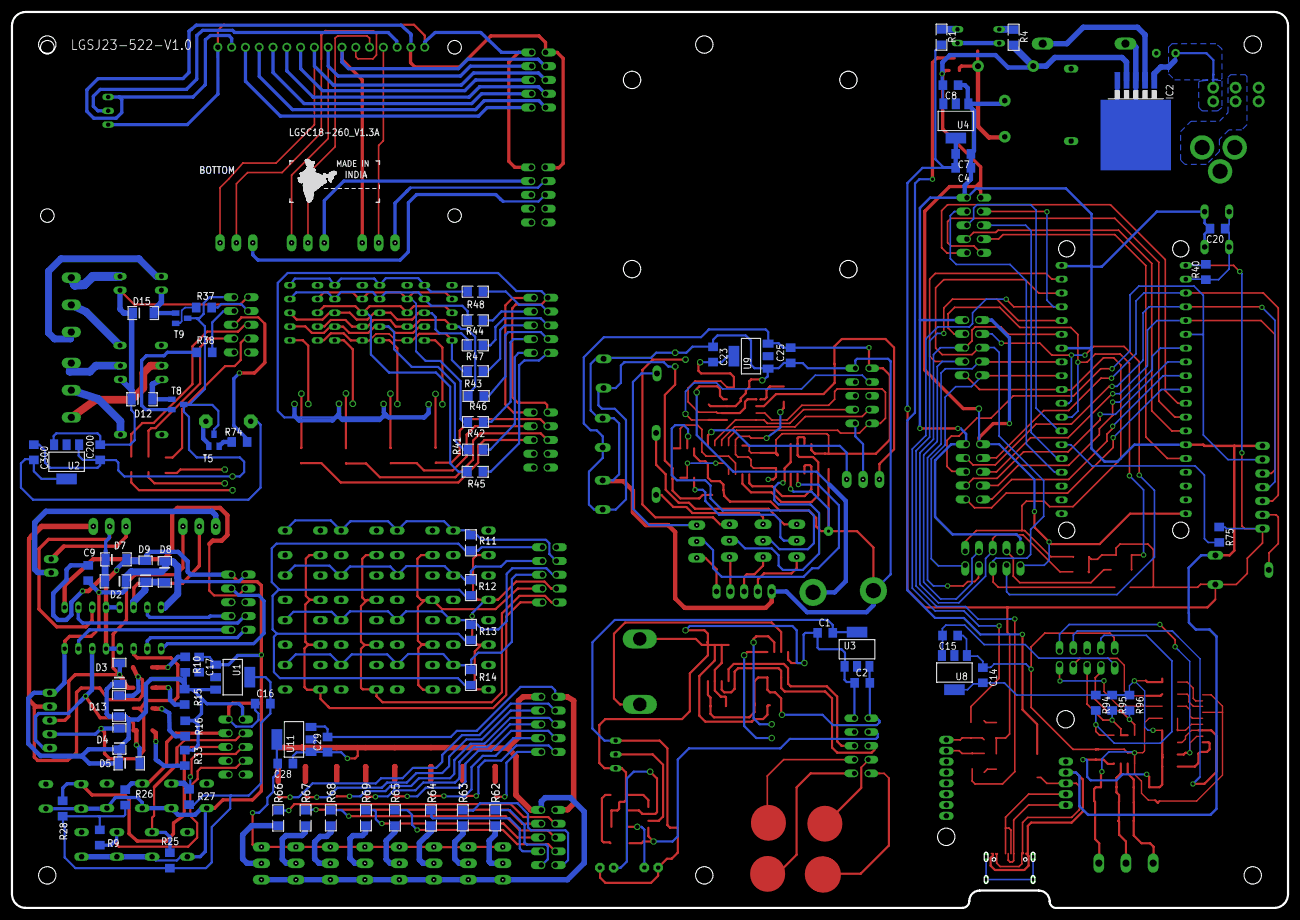
[picture p12: board Esp_DVK.brd from below]

Board: 2 copper layers, 235.0 x 165.0 mm, 269 parts (78 on the bottom side), 246 nets.

Other parts of the board:
U$1: MAD_IN_INDIA
