LogsunSystems/ESP32_DVK/ESP32 DVK CODES/EEPROM 24C04/EEPROM_READ/EEPROM_READ.ino

#include <Wire.h>

#define EEPROM1_I2C_address 0x54

void setup()
{
  Serial.begin(115200);
  Wire.begin(13, 16); //13 SDA   16 SCL
//  unsigned int address = 0;
//  for (int i = 0; i <= 9; i++)
//  {
//    writeToEEPROM(EEPROM1_I2C_address, i, i*2);
//  }
  Serial.println("EEPROM 1: ");
  delay(100);
  for (int i = 0; i <= 9; i++)
  {
    Serial.print("   ");
    Serial.println(readFromEEPROM(EEPROM1_I2C_address, i),DEC);
    delay(700);
  }
}

void loop() {}

//void writeToEEPROM(byte EEPROMAddress, byte dataAddress, byte dataValue)
//{
//  Wire.beginTransmission(EEPROMAddress);
//  Wire.write(dataAddress);
//  Wire.write(dataValue);
//  Wire.endTransmission();
//  delay(5);
//}
byte readFromEEPROM(byte EEPROMAddress, byte dataAddress)
{
  Wire.beginTransmission(EEPROMAddress);
  Wire.write(dataAddress);
  Wire.endTransmission();
  delay(5);
  Wire.requestFrom(EEPROMAddress, 1);
  if (Wire.available()) return Wire.read();
}
