LogsunSystems/ESP32_DVK/ESP32 DVK CODES/RGB/rgb.ino

void setup() {
  // initialize digital pin 13 as an output.
  pinMode(A0, OUTPUT);
  pinMode(A1, OUTPUT);
  pinMode(A2, OUTPUT);
}

// the loop function runs over and over again forever
void loop() {
  while(1)
  {
  digitalWrite(A0, HIGH);   // turn the LED on (HIGH is the voltage level)
  delay(1000);              // wait for a second
  
  digitalWrite(A0, LOW);   // turn the LED on (HIGH is the voltage level)
  delay(1000);              // wait for a second
 digitalWrite(A1, HIGH);   // turn the LED on (HIGH is the voltage level)
  delay(1000);              // wait for a second
digitalWrite(A1, LOW);   // turn the LED on (HIGH is the voltage level)
  delay(1000);
digitalWrite(A2, HIGH);   // turn the LED on (HIGH is the voltage level)
  delay(1000);              // wait for a second
digitalWrite(A2, LOW);   // turn the LED on (HIGH is the voltage level)
  delay(1000);  
  
  }
}
