LogsunSystems/ESP32_DVK/(commit log)

2023-11-11 ESP32 DVK
    [Esp_DVK.brd, Esp_DVK.csv, Esp_DVK.sch]
2023-11-11 Sample Codes added
